salmin36/arduino-webasto-gsm/images/arduino.png

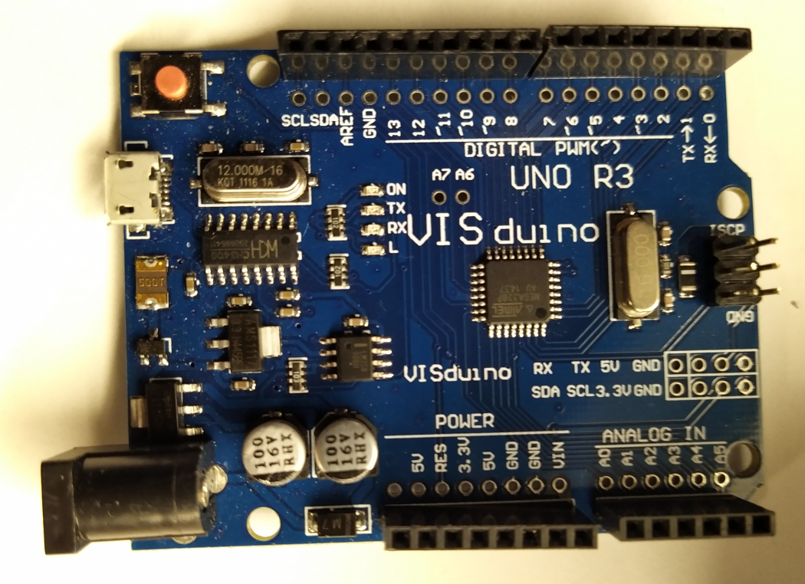
images/arduino.png
