salmin36/arduino-webasto-gsm/images/shield.png

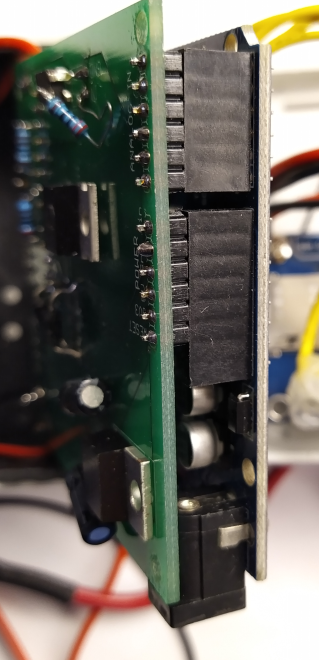
images/shield.png
