salmin36/arduino-webasto-gsm/images/sim800.png

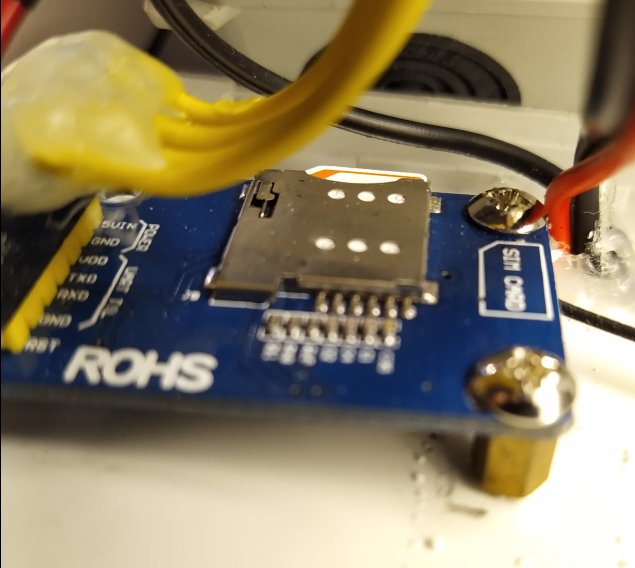
images/sim800.png
