salmin36/arduino-webasto-gsm/images/temp-sensor.png

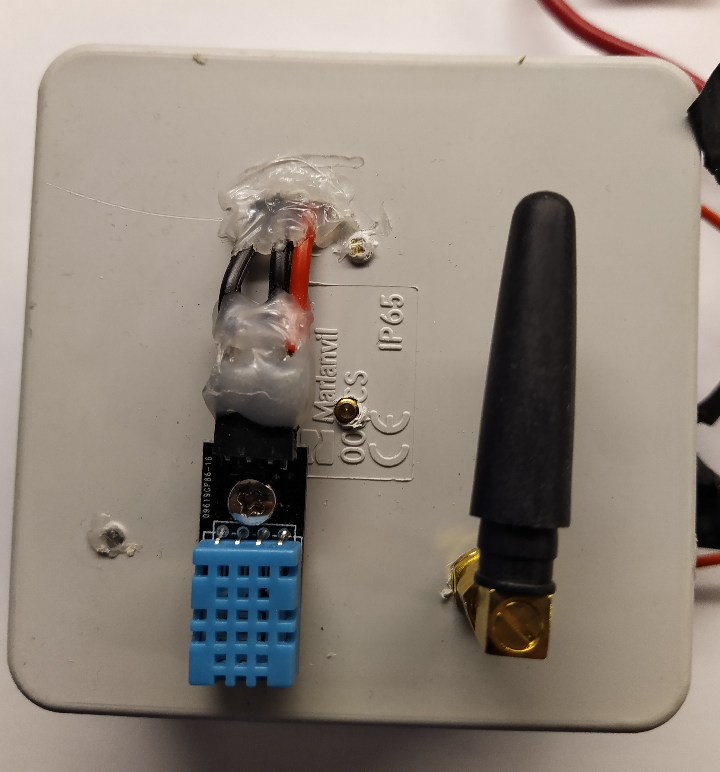
images/temp-sensor.png
