salmin36/arduino-webasto-gsm/(commit log)

2020-10-27 Add arduino code
2020-10-27 Added gerber files
2020-10-27 Added picture of pcb
2020-10-27 Added photos of prototype
